ikeji/hidmon/TODO.txt

* register hid module to gem.
* register hidmon module to gem.
