ikeji/hidmon/docs/hidspx/Changelog.txt

HIDaspx and hidspx. 2008-09-29
-----------------
- first public version
