ikeji/hidmon/src/utils.c

/* utils.c
 * avrspx support routines
 * 2006-05-08 by t.k
 */
#include <stdio.h>
#include <string.h>
#include <stdlib.h>
#include <ctype.h>
#include <limits.h>
#include <windows.h>
#include "avrspx.h"

//----------------------------------------------------------------------------
#ifndef PATH_MAX
#define PATH_MAX 1024
#endif

char *progpathname;
char progpath[PATH_MAX];
char progname[FILENAME_MAX];
char inifilename[FILENAME_MAX];

//----------------------------------------------------------------------------
bool is_binary_str(const char *s)
{
    while (*s) {
        if (*s != '0' && *s != '1')
            return false;
        ++s;
    }
    return true;
}

// default is a binary string (original compatiblity)
unsigned long strtoul_ex(const char *s, char **endptr, int base)
{
    if (base != 0 || (*s != '0' && *s != '1'))
        return strtoul(s, endptr, base);
    if (*s == '0' && *(s + 1) == 'b')   // 0b....
        return strtoul(s + 2, endptr, 2);
    return strtoul(s, endptr, is_binary_str(s) ? 2 : 0);
}

//----------------------------------------------------------------------------
int setup_commands_ex(int argc, char **argv)
{
    char *s;

#if 1
    GetModuleFileName( NULL, progpath, MAX_PATH );
    progpathname = *argv;
#else
    progpathname = *argv;
    strcpy(progpath, progpathname);
#endif
    s = progpath + strlen(progpath);
    while (--s >= progpath && (*s != ':' && *s != '\\'))
        ;
    strcpy(progname, s + 1);
    *(s+1) = '\0';

    s = progname + strlen(progname);
    while (--s > progname && *s != '.')
        ;
    if (*s == '.')
        *s = '\0';

//    strcpy(inifilename, progpath);
    strcat(inifilename, progname);
    strcat(inifilename, ".ini");

    while (--argc) {
        s = *++argv;
        if (*s == '-' && tolower(s[1]) == 'i') {    // -i<config.ini>
            // -i option
            strcpy(inifilename, s + 2);
        }
    }
#if 0
    fprintf(stderr, "prog path name [%s]\n", progpathname);
    fprintf(stderr, "prog path      [%s]\n", progpath);
    fprintf(stderr, "prog name      [%s]\n", progname);
    fprintf(stderr, "ini file name  [%s]\n", INIFILE);
#endif

    return argc;
}

//----------------------------------------------------------------------------
DEVPROP *search_device(char *Name)
{
    DEVPROP *dev;

    // @@@
    for (dev = (DEVPROP *)DevLst; dev->Name != NULL; dev++) {
        if (stricmp(Name, dev->Name) == 0)
            return dev;
        if (tolower(Name[0]) == 'a' &&
            tolower(Name[1]) == 't' &&
            stricmp(Name+2, dev->Name) == 0)
            return dev;
    }
#if 1   // 2010/08/05
    for (dev = (DEVPROP *)DevLst; dev->part_id != NULL; dev++) {
        if (stricmp(Name, dev->part_id) == 0)
            return dev;
    }
#endif
    return NULL;
}

#if 0
DEVPROP *get_device(BYTE *p)
{
    DEVPROP *dev;
    // @@@
    for (dev = (DEVPROP *)DevLst; dev->Name != 0; dev++) {
        if (memcmp(p, Device->Sign, 3) == 0)
            return dev;
    }
    return dev;
//  return NULL;
}
#endif

//----------------------------------------------------------------------------
int get_outque_count(HANDLE hComm)
{
    COMSTAT ComStat;
    DWORD dwError;

    if (ClearCommError(hComm, &dwError, &ComStat))
        return ComStat.cbOutQue;
    return -1;
}

static int check_comm(int port)
{
    char sComm[16];
    HANDLE hComm;

    sprintf(sComm, "\\\\.\\COM%u", port);
    hComm = CreateFile(sComm, GENERIC_READ|GENERIC_WRITE, 0, NULL,
            OPEN_EXISTING, FILE_ATTRIBUTE_NORMAL, NULL);

    if (hComm == INVALID_HANDLE_VALUE) {
        DWORD code = GetLastError();
// 2: 指定されたファイルが見つかりません
// 5: アクセスは拒否されました
// fprintf(stderr, "Err = %d\n", code);
        if (code == 5)
            fprintf(stderr, "  COM%d busy.\n", port);
        return 0;
    }

    CloseHandle(hComm);
    fprintf(stderr, "  COM%d ready.\n", port);
    return 1;
}

void dump_port_list(void)
{
    int n;

    fprintf(stderr, "--- port list ---\n");
    for (n = 1; n <= 32; ++n)
        check_comm(n);
}
//----------------------------------------------------------------------------
