ikeji/hidmon/(commit log)

2012-02-20 import from hidspx-0922.zip
    [mod-diff.txt]
2012-02-20 import from hidspx-0924.zip
    [mod-diff.txt]
2012-02-24 Fix indent and expand tab.
    [main-small.c, main.c]
2012-02-28 Implement FastPWM0 class and Servo class.
